fractalxaos/weather/Raspberry Pi Model/Readme.md

<html>
<body>
<h4>DIY Weather Station</h4>
<p>
Building Raspberry Pi weather station is an exciting way to learn about Raspberry Pies and the "Internet of Things".  Building the weather station will give you an excellent introduction to a variety of technologies.  See the <a href="docs/weather_station_project_description_pi.pdf">project description document</a> for details on how to obtain and assemble the weather station and install the software.
</p>

<hr>
<br>
</body>
</html>
