fractalxaos/weather/docs/images/WeatherWebPage.jpg

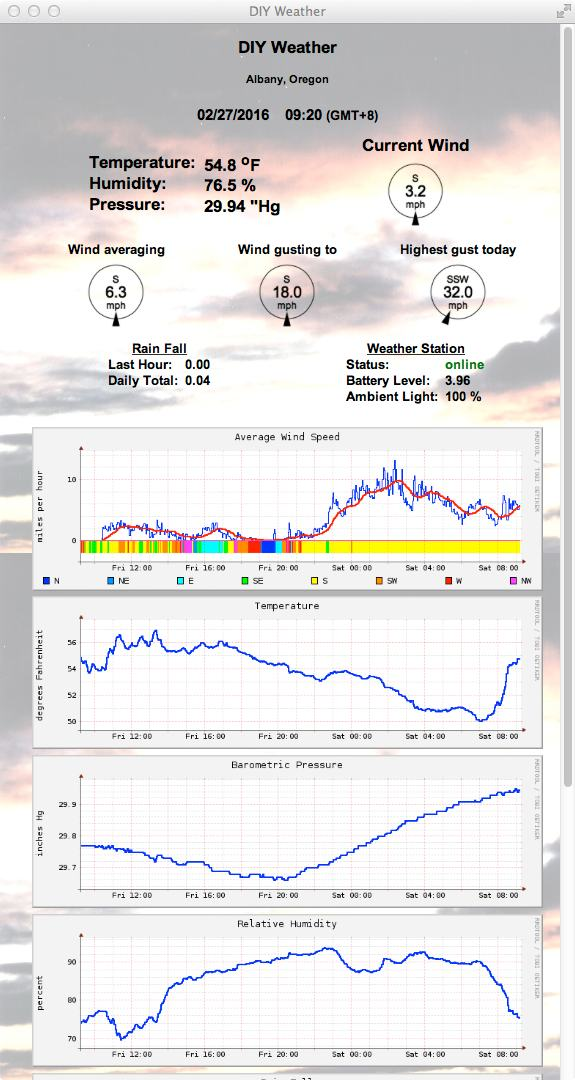
docs/images/WeatherWebPage.jpg
