fractalxaos/weather/Raspberry Pi Model/docs/datasheets/R-Pi-Zero-Pinout-and-Specifications.jpg

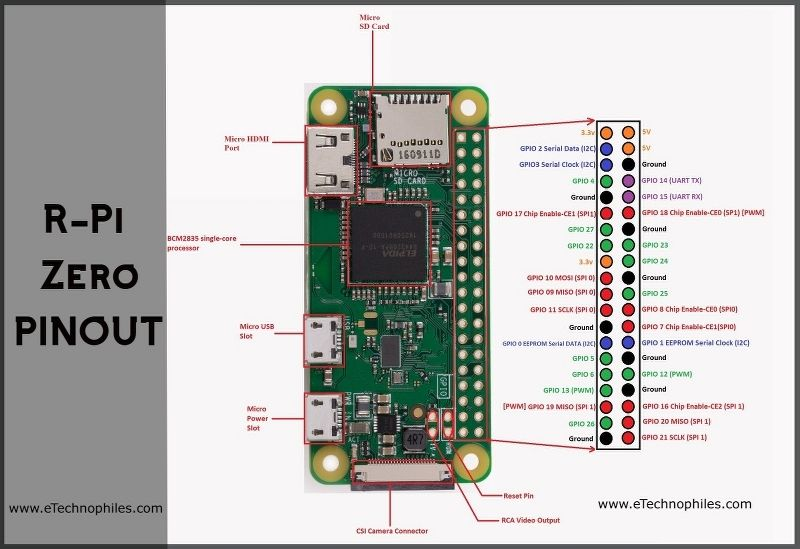
Raspberry Pi Model/docs/datasheets/R-Pi-Zero-Pinout-and-Specifications.jpg
