fractalxaos/weather/Arduino Model/docs/images/WeatherStationElectronics_assembly.jpg

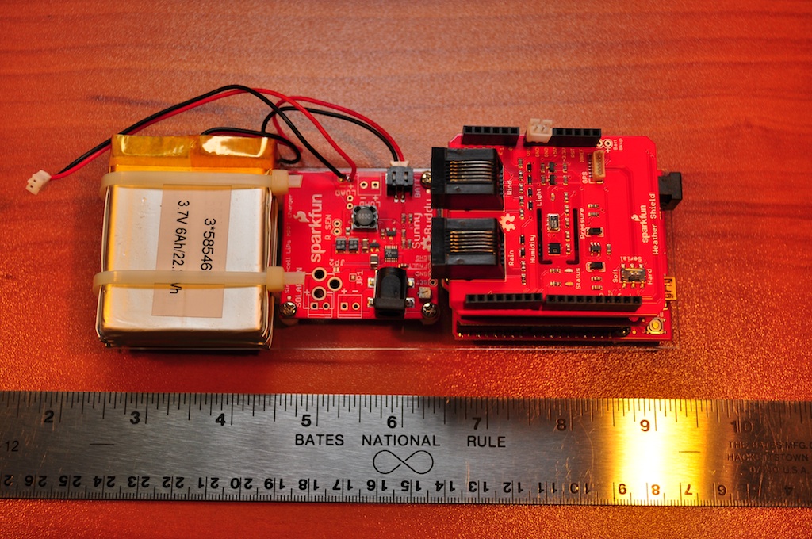
Arduino Model/docs/images/WeatherStationElectronics_assembly.jpg
