fractalxaos/weather/Raspberry Pi Model/docs/weather_station_schematic.pdf

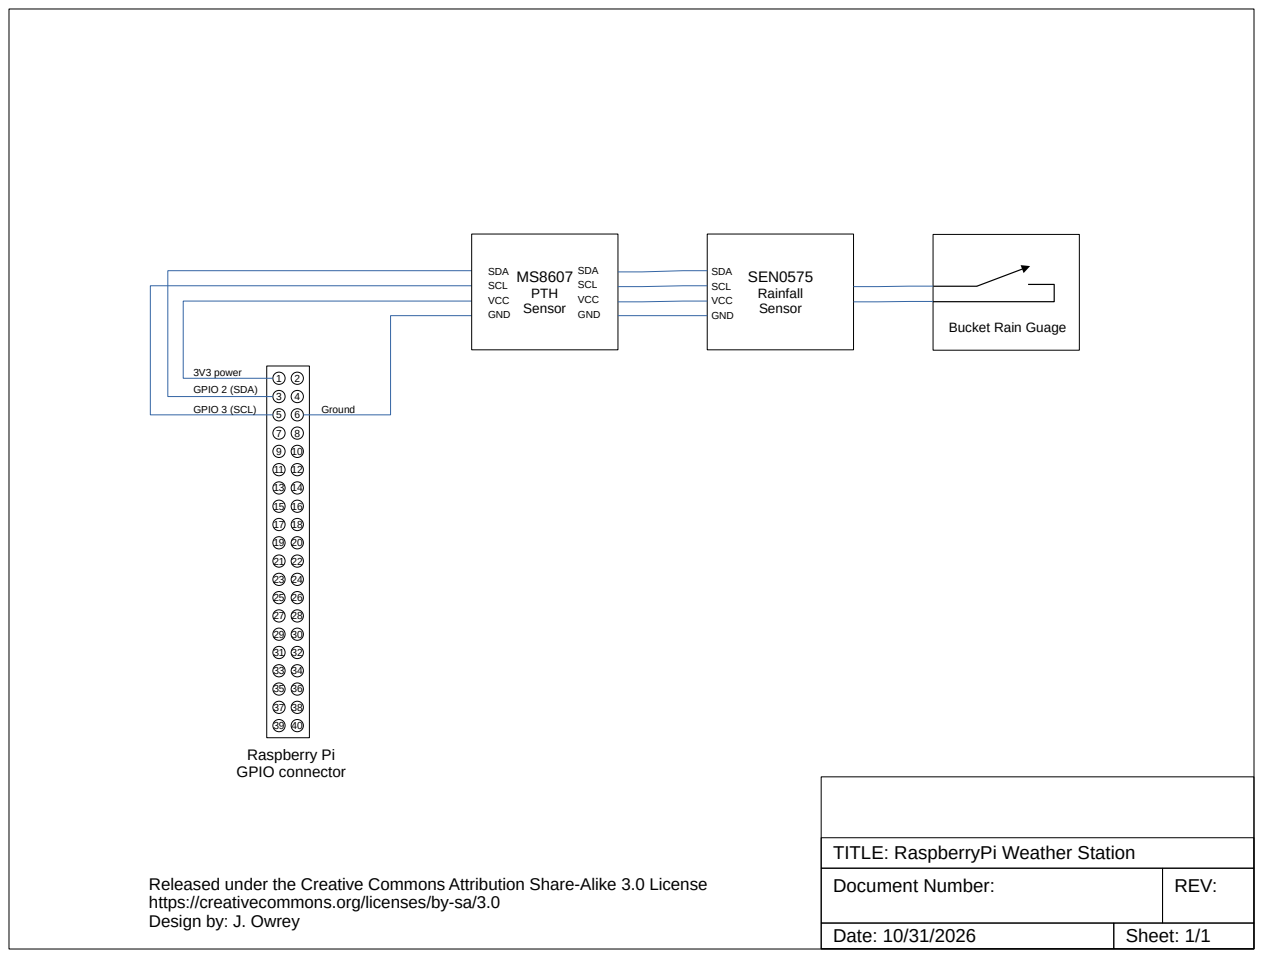
[picture p13: page 1]
3V3 power; GPIO 2 (SDA); GPIO 3 (SCL); Ground; Raspberry Pi GPIO connector; MS8607 PTH Sensor; SDA SCL VCC GND; SEN0575 Rainfall Sensor

Bucket Rain Guage

TITLE: RaspberryPi Weather Station

Released under the Creative Commons Attribution Share-Alike 3.0 License
https://creativecommons.org/licenses/by-sa/3.0
Design by: J. Owrey

Document Number: | REV:

Date: 10/31/2026 | Sheet: 1/1
