fractalxaos/weather/Raspberry Pi Model/bin/createWeatherRrd.py

#!/usr/bin/python3 -u
## The -u option turns off block buffering of python output. This assures
## that error messages get printed to the log file as they happen.
#  
# Module: createWeatherRrd.py
#
# Description: Creates a rrdtool database for use by the weather agent to
# store the data from the weather station.  The agent uses the data in the
# database to generate graphic charts for display in the weather station
# web page.
#
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
# Revision History
#   * v10 released 15 Sep 2015 by J L Owrey: first release
#   * v11 released 12 Jun 2025 by J L Owrey: changed rainin to hourly_rain
#
# Example of rrdtool create database command line executed by this program:
#
#   rrdtool create /home/jeff/database/weatherData.rrd --step 60
#   DS:windspeedmph:GAUGE:120:U:U DS:winddir:GAUGE:120:U:U 
#   DS:tempf:GAUGE:120:U:U DS:hourly_rain:GAUGE:120:U:U DS:pressure:
#   GAUGE:120:U:UDS:humidity:GAUGE:120:U:U RRA:AVERAGE:0.5:1:2880
#    RRA:AVERAGE:0.5:30:17760
#
#2345678901234567890123456789012345678901234567890123456789012345678901234567890

import os
import subprocess
import shutil

    ### DEFINE CONSTANTS ###

_USER = os.environ['USER']
_RRD_FILE = "/home/%s/database/weatherData.rrd" % _USER  # rrd database file
_RRD_SIZE_IN_DAYS = 1470 # days
_RRA_CONSOLIDATION_PERIOD = 300 # seconds - 5 minutes of data
_DATABASE_UPDATE_INTERVAL = 60 # seconds

def createRrdFile():
    """Creates a rrdtool round robin database file.  The file when
       first created does not contain any data.  The file will be
       written to the ~/database folder.
       Parameters: none
       Returns: True, if successful
    """

    if os.path.exists(_RRD_FILE):
        print("rrdtool weather database file already exists!")
        user_input = input('Create a new database (yes/no): ')
        if user_input.lower() == 'no':
          return False
        elif user_input.lower() == 'yes':
          backup_database(_RRD_FILE)
        else:
          return False
          
    ## Calculate database size
 
    heartBeat = 2 * _DATABASE_UPDATE_INTERVAL
    numRraStepsPerDay = int(round(86400 / _RRA_CONSOLIDATION_PERIOD))
    num48hrRraRows = int(2 * round(86400 / _DATABASE_UPDATE_INTERVAL))
    numPDPsPerRraStep = int(round(_RRA_CONSOLIDATION_PERIOD / \
                            _DATABASE_UPDATE_INTERVAL ))
    numRraRows = numRraStepsPerDay * _RRD_SIZE_IN_DAYS
      
    # Format the rrdtool create command.

    strFmt = ("rrdtool create %s --step %s "
             #"--source /home/pi/database/weatherData_20261025.rrd "
             "DS:windspeedmph:GAUGE:%s:U:U DS:winddir:GAUGE:%s:U:U "
             "DS:tempf:GAUGE:%s:U:U DS:hourly_rain:GAUGE:%s:U:U "
             "DS:pressure:GAUGE:%s:U:U DS:humidity:GAUGE:%s:U:U "
             "RRA:AVERAGE:0.5:1:%s RRA:AVERAGE:0.5:%s:%s")

    strCmd = strFmt % (_RRD_FILE, _DATABASE_UPDATE_INTERVAL, \
                heartBeat, heartBeat, heartBeat, heartBeat, heartBeat, \
                heartBeat, num48hrRraRows, numPDPsPerRraStep, numRraRows)
   
    print("Creating rrdtool database...\n\n%s\n" % strCmd) # DEBUG

    # Run the command in a subprocess.
    try:
        subprocess.check_output(strCmd, stderr=subprocess.STDOUT, \
                                shell=True)
    except subprocess.CalledProcessError as exError:
        print("rrdtool create failed: %s" % (exError.output))
        return False
    return True
##end def

def backup_database( path ):
      dPath, file_name = os.path.split(path)
      name, ext = os.path.splitext(file_name)
      bak_file = name + '_bak' + ext
      bak_path = dPath + '/' + bak_file
      print('saving existing database as %s\n' % bak_path)
      shutil.copy(path, bak_path)
## end def

def main():
    createRrdFile()
## end def

if __name__ == '__main__':
    main()
