fractalxaos/weather/(notices)

Notices in the files:
Arduino Model/Arduino/WeatherStation/WeatherStation.ino:
Copyright 2016 Jeff Owrey
This program is free software: you can redistribute it and/or modify
it under the terms of the GNU General Public License as published by
the Free Software Foundation, either version 3 of the License, or
(at your option) any later version.
Raspberry Pi Model/bin/weatherAgent.py:
Copyright 2021 Jeff Owrey
Raspberry Pi Model/bin/createWeatherRrd.py:
Copyright 2015 Jeff Owrey
